leungkimming/BatMan1/ESP32-C6-LCD-1.47/Arduino/ReadMe.txt

中文：	
	如果要运行 LCD_Image 示例，需要先准备一张SD卡，然后将 SD Card File 文件夹下的文件拷贝至SD卡中

//////////////////////////////////////////////////////////////////////////////////////////////////////////////////////////////////////////////////////////////////////
English:	
	To run the LCD_Image example, you need to get an SD Card and copy the files in the SD Card File folder to the SD card

//////////////////// Michael ////////////
document/Arduino/libraries/lvgl/lv_conf_template.h ->
document/Arduino/libraries/lv_conf.h

ESP32-C6-LCD-1/Arduino/libraries/lvgl/demos -> 
ESP32-C6-LCD-1/Arduino/examples/LVGL_Arduino

-> text section too big!!!

ESP32-C6-LCD-1/Arduino/examples/LVGL_Image just compile and works!!!

https://www.reddit.com/r/esp32/comments/1htrdwj/waveshare_esp32c6_147_inch_display_arduino_sketch/
