leungkimming/BatMan1/ESP32-C6-LCD-1.47/batman7/design.txt

你的方向是對的，而且比純電壓法更接近真正的 SOC。

不過有一個關鍵問題：

單靠「充進去了多少 Wh」不能直接換算成「目前剩餘 %SOC」，除非你知道電池目前是從多少 % 開始充。

但如果你的目標是：

每次充電後利用充入的 Wh 估算電池容量狀態

那是可行的。

第一個公式

電池儲能：

Wh = V × Ah

你的電池：

24V × 60Ah = 1440Wh

但對鋰電池而言，用名義電壓 24V 會有些誤差。

如果是 7S Li-ion：

Nominal Voltage ≈ 25.2V

則：

25.2V × 60Ah

= 1512Wh

所以你的電池總能量約：

1500Wh

左右。

第二個公式

若充入：

200Wh

理論上：

SOC增加

= 200 / 1512

= 13.2%

即：

200Wh ≈ 13%
容量

換算表

以 1512Wh 為基準：

充入Wh	SOC增加100Wh	6.6%
200Wh	13.2%
300Wh	19.8%
400Wh	26.5%
500Wh	33.1%
600Wh	39.7%
700Wh	46.3%
800Wh	52.9%
1000Wh	66.1%
更簡單的公式

對你的電池：

SOC%

≈

Wh / 15

因為：

1512Wh / 100

≈ 15Wh

所以：

150Wh ≈ 10%
300Wh ≈ 20%
450Wh ≈ 30%
600Wh ≈ 40%
750Wh ≈ 50%

這個非常容易在 ESP32 裡計算。

但要注意充電效率

實際量到：

從充電器輸出

不等於

進入電池

例如：

充電器效率 90%
BMS損耗
線材損耗

實際可能：

充電器輸出 500Wh

電池只吸收 450Wh

因此建議加入：

Charging_Efficiency = 0.9

公式：

SOC_gain =
(Wh_charged * 0.9)
/
1512
*
100

我會怎樣做 BatMan

你的 BatMan 已有 INA226。

我會記錄：

Charge Start:
26.3V

Charge End:
29.4V

Charged:
420Wh

然後用：

SOC_before
=
100
-
420/1512×100

=
72%

即推算：

充電前約72%

其實你還可以做得更準

我看你的構想後，我會建議：

Stage 1

顯示電壓

29.4V
26.3V

Stage 2

記錄每次充電 Wh

例如：

Cycle #12

Start:
26.3V

End:
29.4V

Added:
458Wh

Stage 3（最有價值）

建立你自己的 Wingus 曲線：

例如幾次之後發現：

29.4V → 100%

26.3V → 450Wh缺口

26.3V
=
(1512-450)/1512

=
70%

結果會發現：

26.3V ≈ 70%

或者

26.3V ≈ 45%

這取決於 Panasonic 電池的實際放電曲線。

這比網上的 Li-ion 表準確得多，因為它是從你的實際充電數據反推。

我覺得你的方案最大的優點是：

不需要打開 Wingus 黑盒攔截主電流。

你只需在充電器與充電插座之間串入 BatMan，就能累積每次充入的 Wh，再逐步建立：

Voltage ↔ Remaining Wh ↔ SOC

最後得到一條專屬於你這組 Panasonic 24V 60Ah 的校正曲線，而不再需要依賴 PG Drives 的 5 格燈。
