leungkimming/BatMan1/ESP32TouchLCD/BatMan5T/HW/ESP32-S3-Touch-LCD-2.pdf

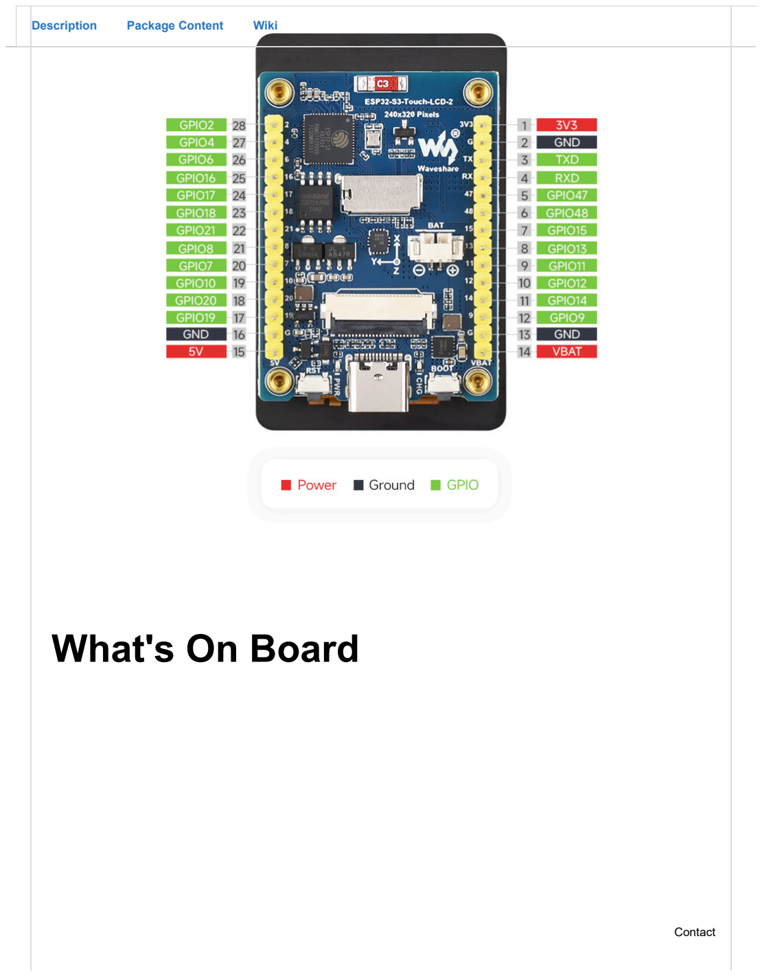
[picture p6: page 1]

# What's On Board

Description | Package Content | Wiki

Contact

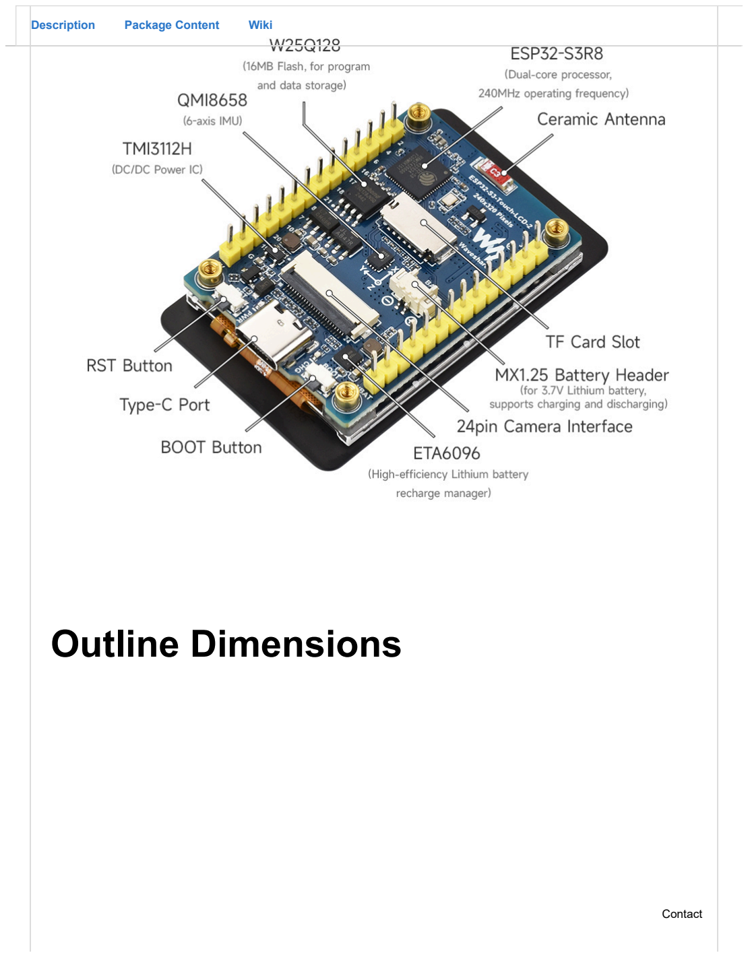
[picture p7: page 2]

# Outline Dimensions

Description | Package Content | Wiki

Contact

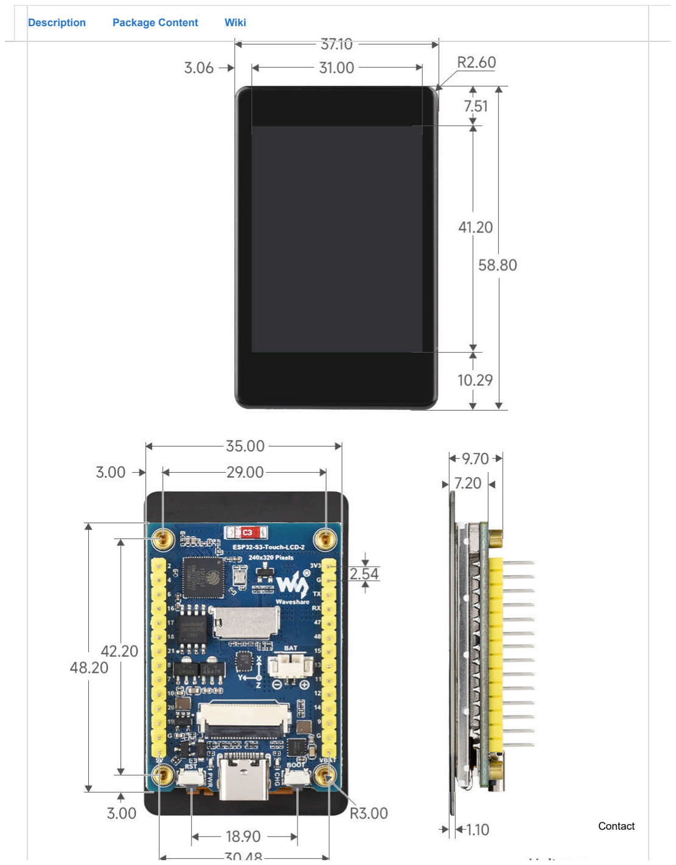
[picture p8: page 3]

Description | Package Content | Wiki

Contact
