leungkimming/BatMan1/ESP32-C6-LCD-1.47/9014 (1).PDF

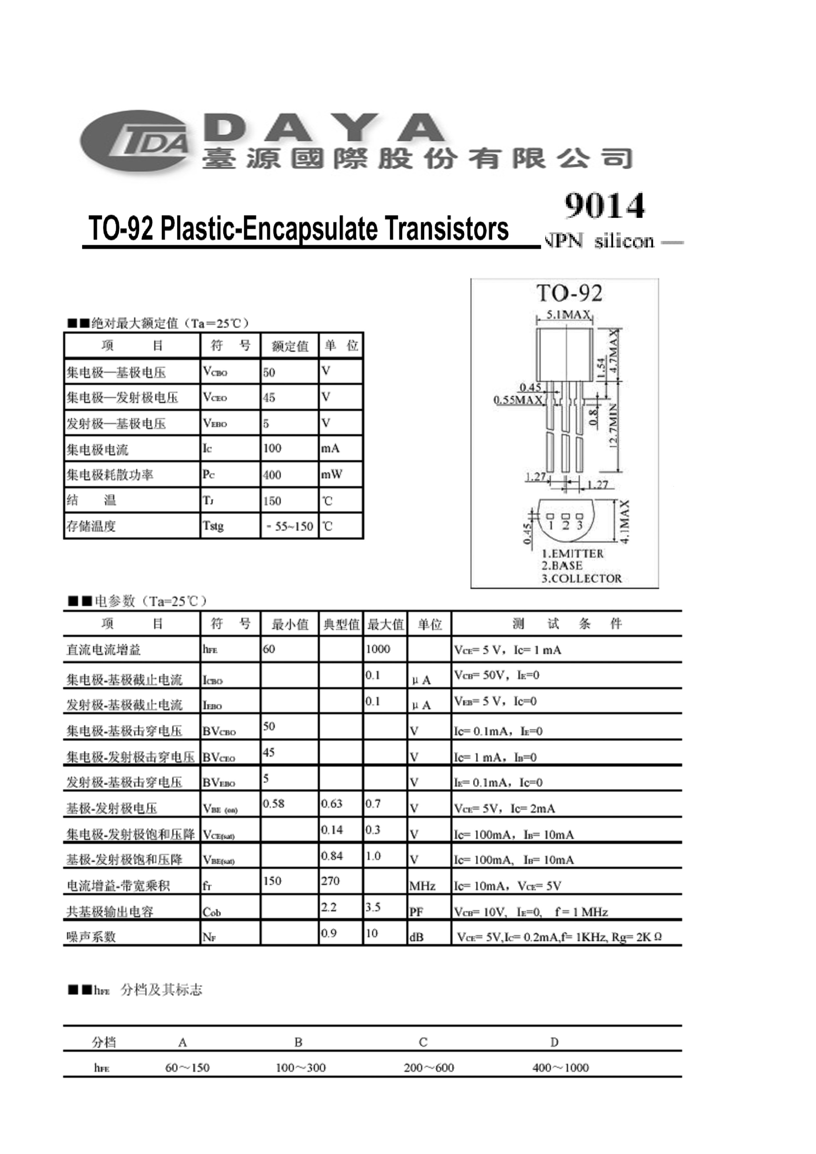
[picture p9: page 1]
