leungkimming/BatMan1/ESP32-C6-LCD-1.47/ESP32-C6-LCD-1.47-details-9.jpg

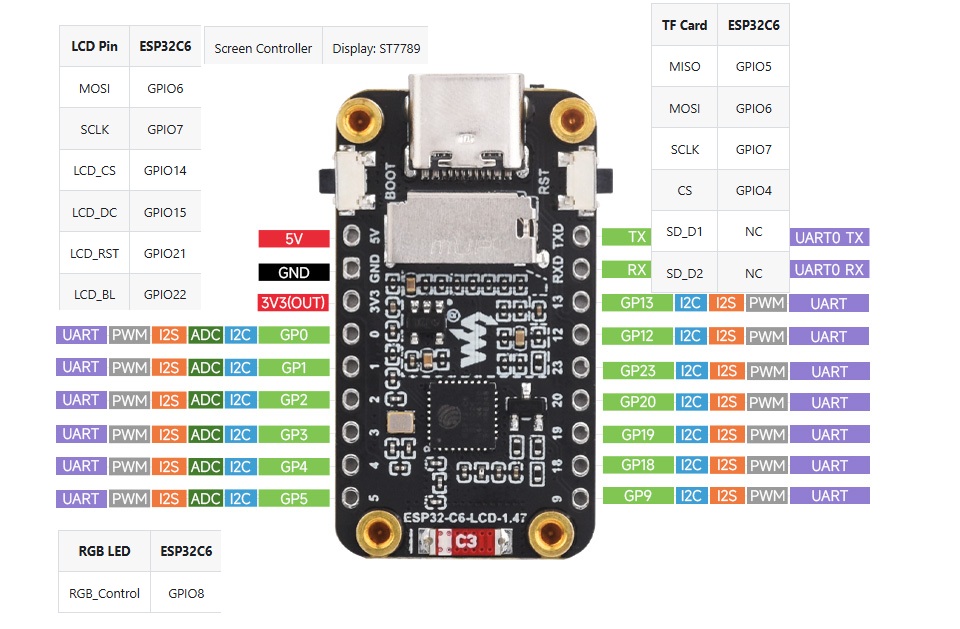
ESP32-C6-LCD-1.47/ESP32-C6-LCD-1.47-details-9.jpg
