leungkimming/BatMan1/ESP32TouchLCD2/BatMan5T/HW/power-supply.png

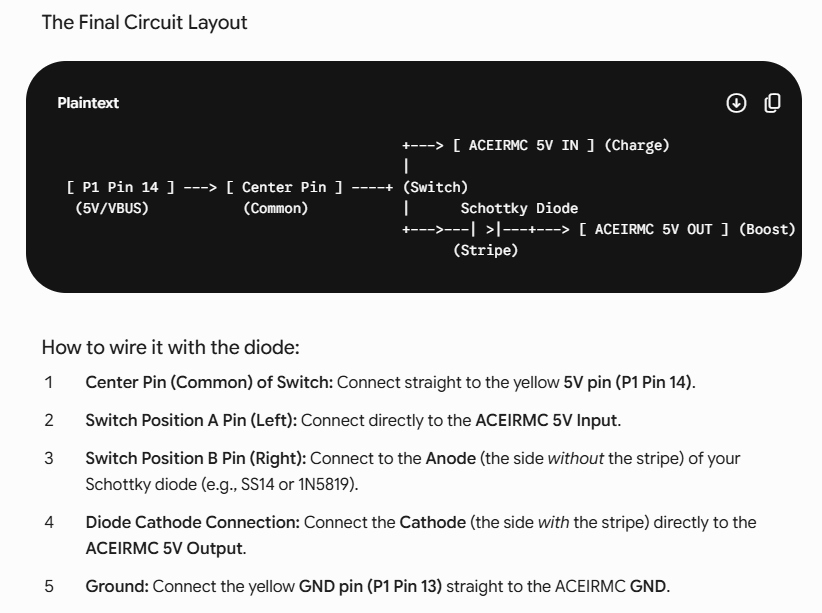
ESP32TouchLCD2/BatMan5T/HW/power-supply.png
