leungkimming/BatMan1/ESP32TouchLCD2/ESPBatMan4/HW/circuit1.png

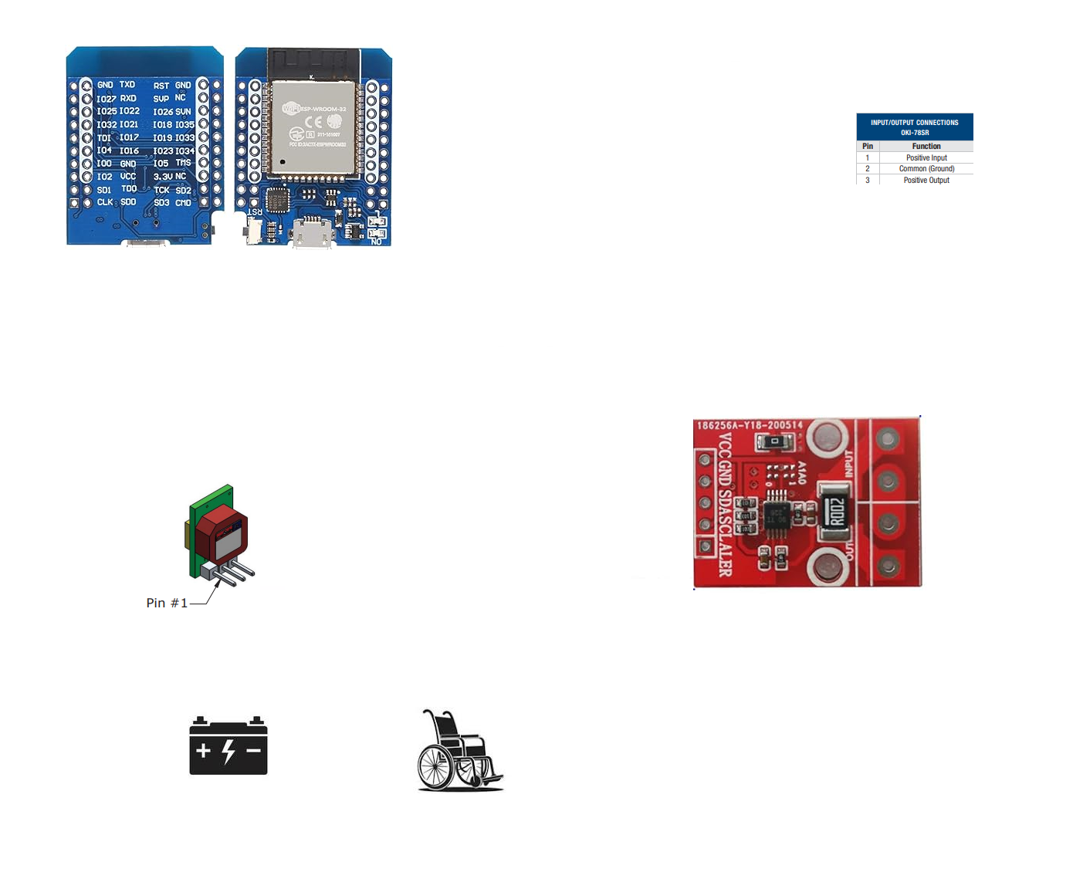
ESP32TouchLCD2/ESPBatMan4/HW/circuit1.png
