leungkimming/BatMan1/ESP32TouchLCD2/ESPBatMan4/HW/MH-ET_LIVE_D1_mini_ESP32_pinout.jpeg

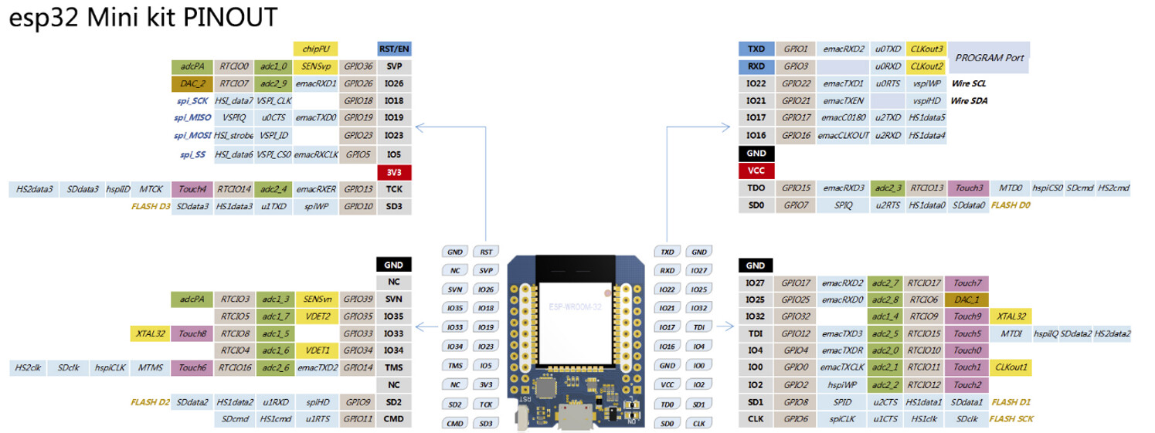
ESP32TouchLCD2/ESPBatMan4/HW/MH-ET_LIVE_D1_mini_ESP32_pinout.jpeg
