leungkimming/BatMan1/ESPBatMan3/HW/anderson.png

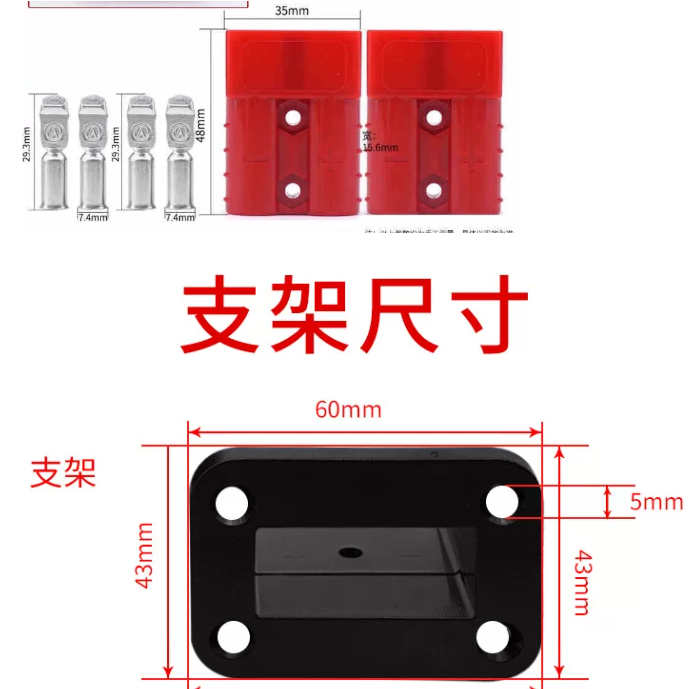
ESPBatMan3/HW/anderson.png
