leungkimming/BatMan1/ESPBatMan3/HW/circuit.JPG

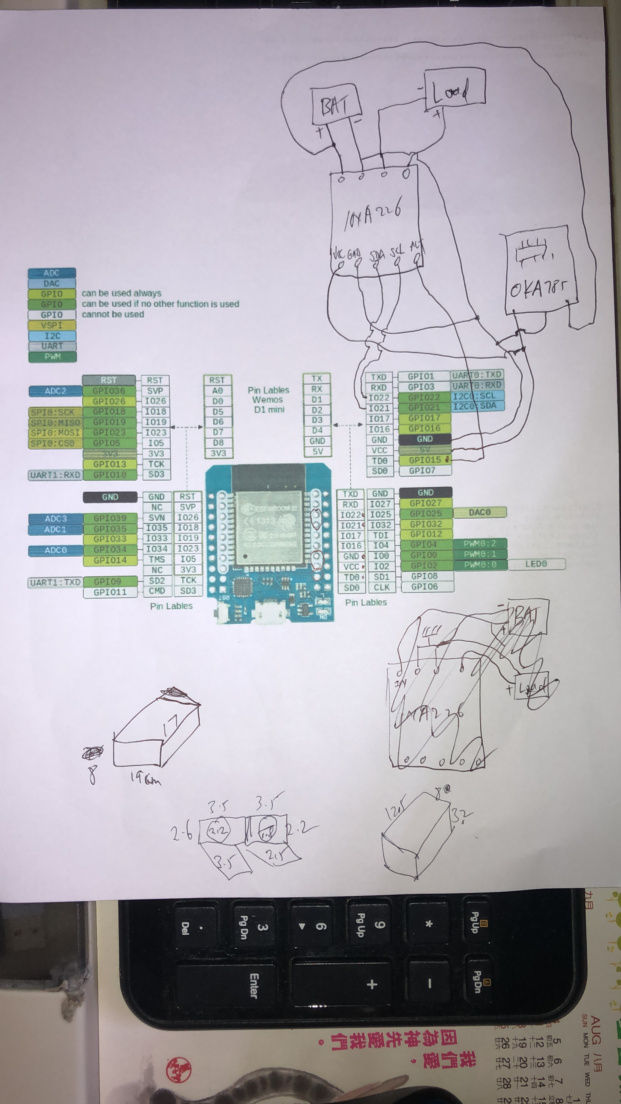
ESPBatMan3/HW/circuit.JPG
