leungkimming/BatMan1/ESPBatMan3/HW/MH-ET_LIVE_D1_mini_ESP32_pinout.png

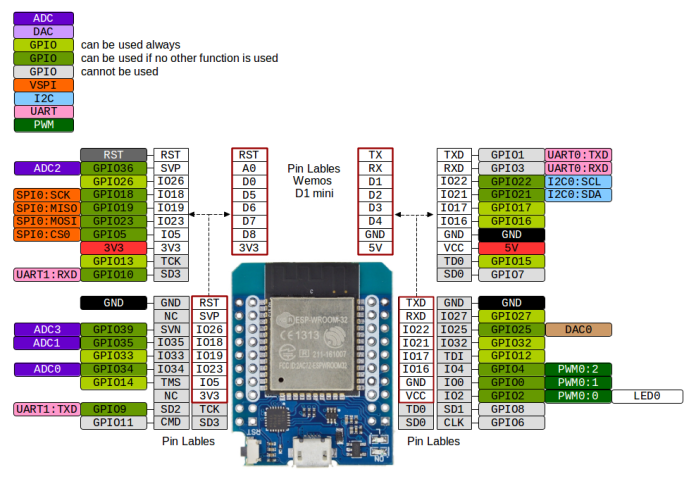
ESPBatMan3/HW/MH-ET_LIVE_D1_mini_ESP32_pinout.png
