leungkimming/BatMan1/ESPBatMan4/HW/batmanx.drawio.png

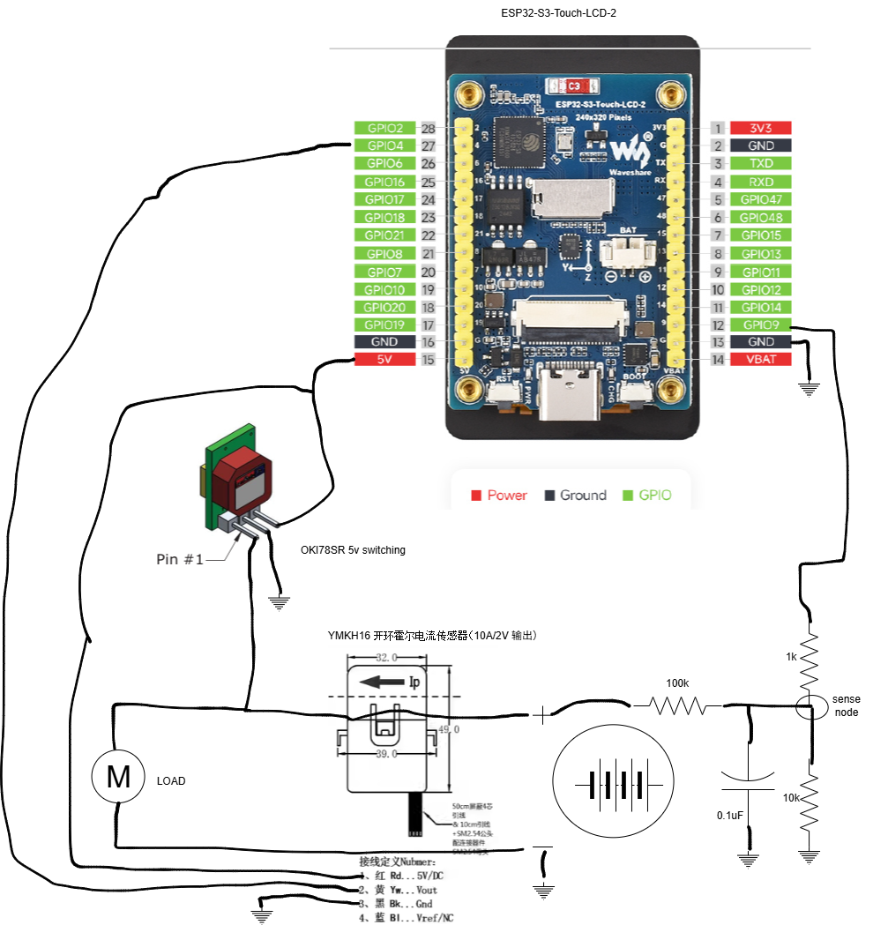
ESPBatMan4/HW/batmanx.drawio.png
