leungkimming/BatMan1/ESPBatMan4/HW/circult2.png

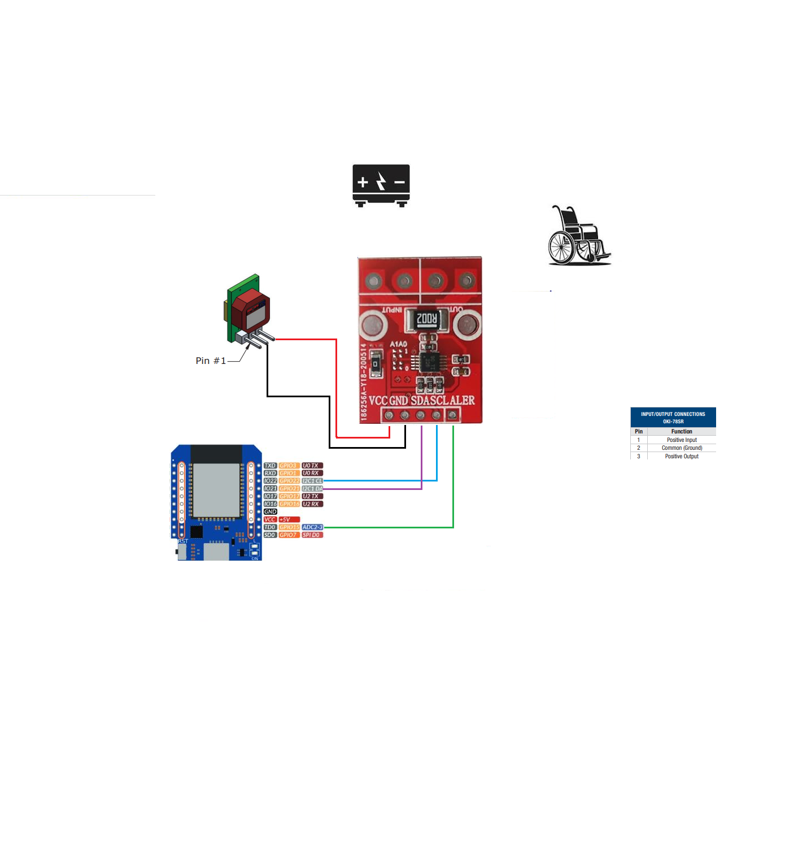
ESPBatMan4/HW/circult2.png
