leungkimming/BatMan1/ESPBatMan4/HW/SCH_Schematic2_1-P1_2026-06-16.png

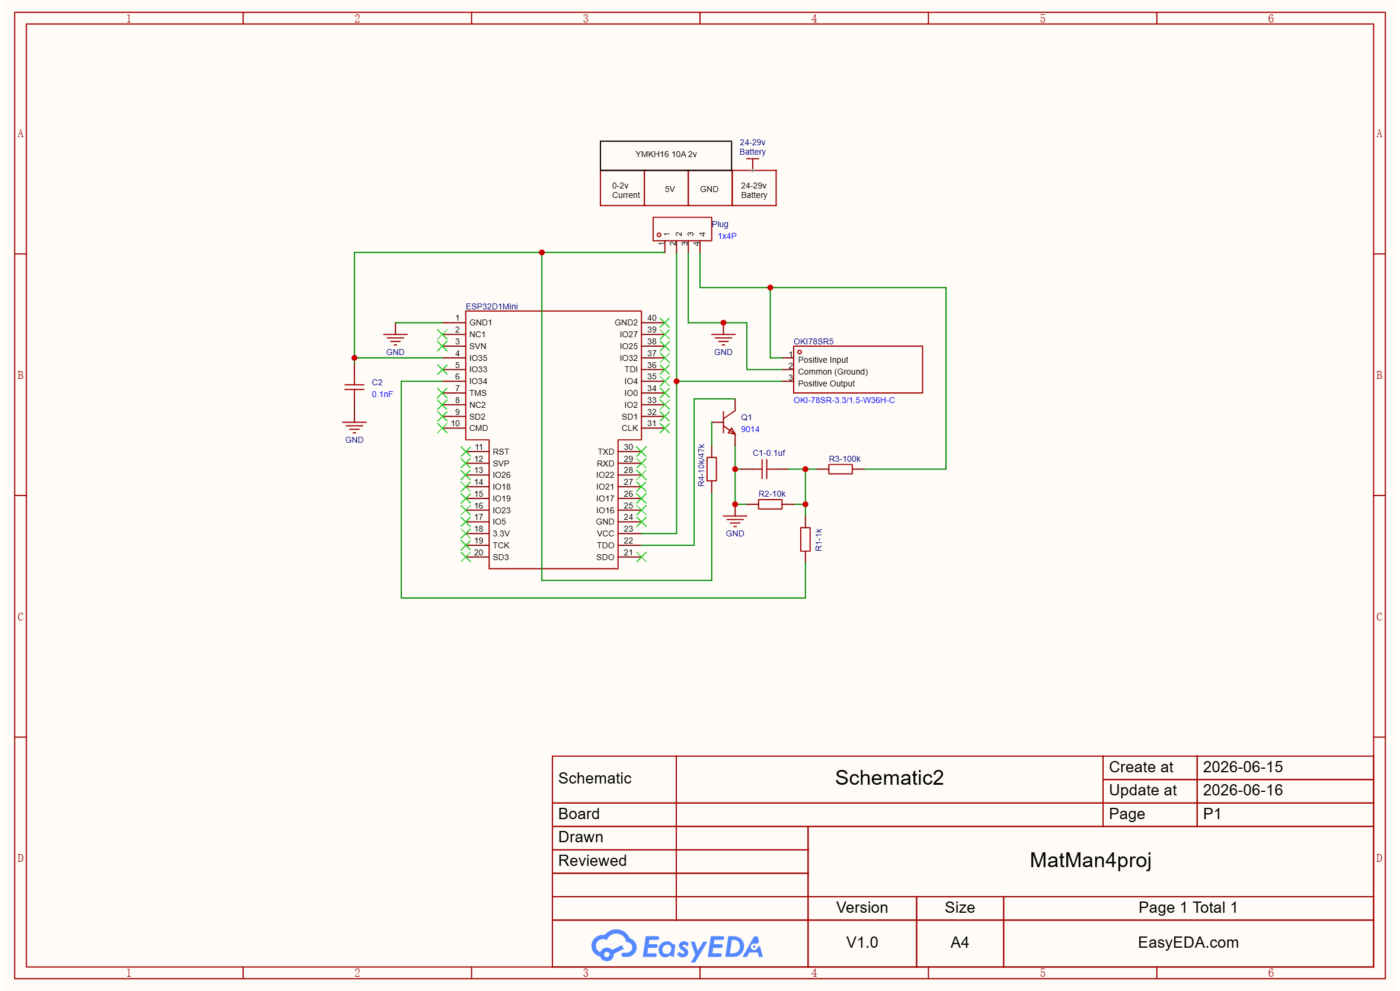
ESPBatMan4/HW/SCH_Schematic2_1-P1_2026-06-16.png
