leungkimming/BatMan1/ESPBatMan4/HW/YMKH16_10A_2v.jpg

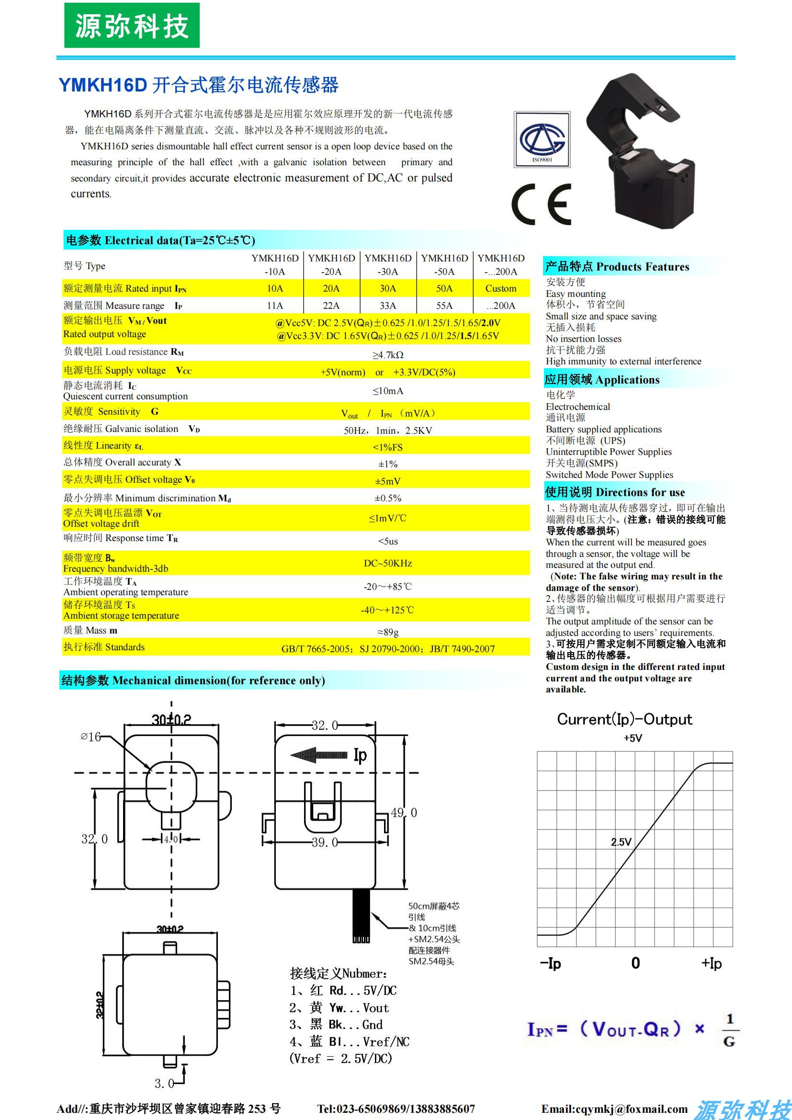
ESPBatMan4/HW/YMKH16_10A_2v.jpg
