leungkimming/BatMan1/Resources/Images/batman.png

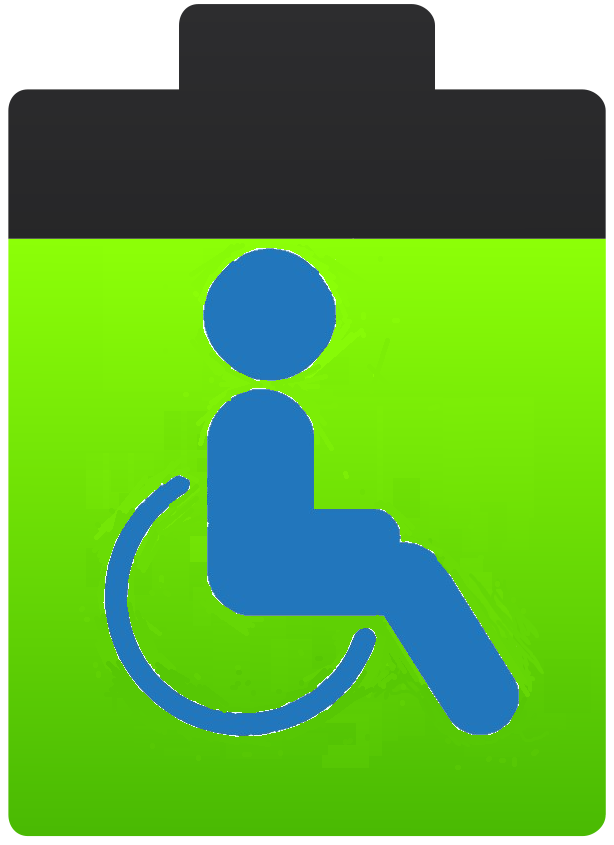
Resources/Images/batman.png
