leungkimming/BatMan1/ESP32C6TouchLCD1.69/ESP32-C6-Touch-LCD-1.69-Schematic.pdf

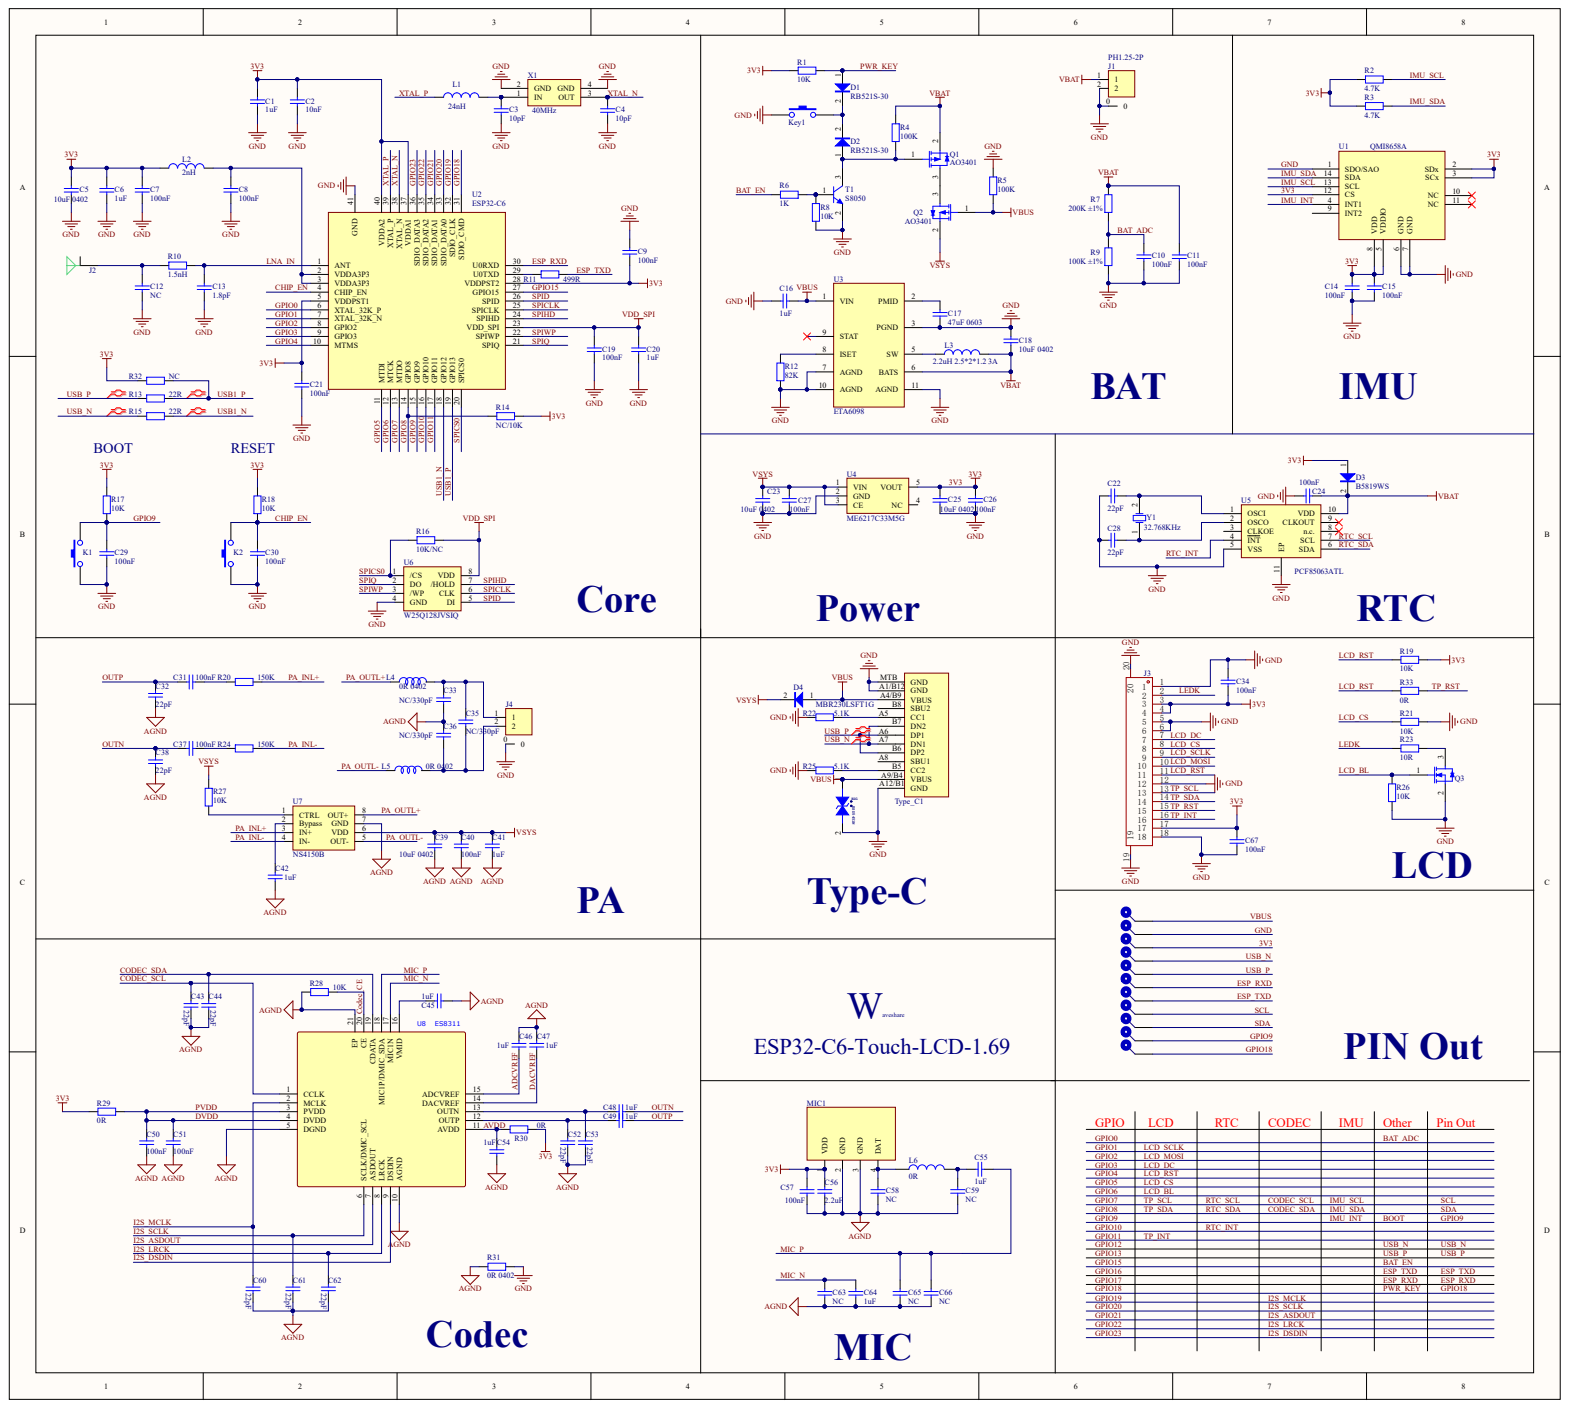
[picture p22: page 1]

CODEC_SDA MIC_P | Waveshare ESP32-C6-Touch-LCD-1.69
CODEC_SCL | | MIC_N

C43 C44 AGND

VMID 16 MIC1N 17 MIC1P/DMIC_SDA 18 CDATA 19 CE 20 EP 21

I2S_ASDOUT
I2S_LRCK
